keredson/chimes/README.md

Made front pages of [Hackaday](https://hackaday.com/2020/12/24/ringing-in-the-holidays-with-self-playing-chimes/) and [Hacker News](https://news.ycombinator.com/item?id=25482856)!

Musical Christmas Bells / Chimes
================================

This project is a battery powered musical chime set, loosely inspired by a set of microprocessor controlled
electro-mechanical real bells we had as kids, I think the
*Ye Merry Minstrel Caroling Christmas Bells*.  Other similar products had light-up bell decorations with a speaker,
like the *Caroling Christmas Bells* or *Mr Christmas Bells of Christmas* (but weren't real bells).

I wanted to recreate, but could not find a source of bells reasonably priced for this project.  So I substituted 
DIY chimes, which worked quite nicely IMO.

Built with a black walnut stand using copper tubing, 3d-printed hangers and controlled by an ESP32 running MicroPython.

Table of Contents
-----------------
- [Watch](#watch)
- [Overview](#overview)
- [Build](#build)
- [Software](#software)
- [Parts](#parts)
- [Tools](#tools-i-used)
- [Future Work](#future-work)

Watch 
-----

Some videos of it working:

Chimes playing 'Hark! The Herald Angels Sing'" (https://youtu.be/q78rXuhWD9I "Playing 'Hark! The Herald Angels Sing'")

- [Silent Night](https://youtu.be/6GucSdeh5fI)
- [Hark! The Herald Angels Sing](https://youtu.be/q78rXuhWD9I)
- [God Rest Ye Merry Gentlemen](https://youtu.be/Mc4dz5KQoJM)
- [Close up of the user interface](https://www.youtube.com/watch?v=E3LkCAIgiEA) (OLED display)

Overview
--------

I chose to implement these 12 notes (which cover a decent number of songs), but it can be extended as needed (up to the free GPIO pins):

- C5, D, E, F, F#, G, A, B, C6, D, E, F

I mapped C5 (and like) to C4 in software since an actual C4 chime didn't really sound like C4 due to secondary frequencies.  [This guide](http://leehite.org/Chimes.htm#Note%20Selection) was very useful to understand what's going on.

I've simplified a number of MIDI files to play, available [here](https://github.com/keredson/chimes/tree/main/songs).

Build
-----
This took me somewhere between 40-80 hours to design, code and build, starting with a "mandatory fun day" event at work.

Get some wood.  This is some black walnut I slabbed a year or two ago:



Make sure it's big enough to fit everything:



Cut and plane and do all the normal stuff to make it look pretty:





Cut 12 copper tubes to length.  I found an excellent guide at http://leehite.org/Chimes.htm.  I bought two 
[10' sections of type M 1/2" copper pipe](https://www.homedepot.com/p/Cerro-1-2-in-x-10-ft-Copper-Type-M-Hard-Temper-Straight-Pipe-1-2-M-10/100354198)
and cut them accorting to [this guide](https://github.com/keredson/chimes/blob/main/Family%20Copper%20Type%20M%20Red.pdf).




Drill and chamfer holes to hang them by at the hang points. 




Make the stand as you please.  I chose some pretty simple feet and through tenons.  






Make some electromagnets using 1.25" pieces of [3/8 in. Plain Steel Round Rod](https://www.homedepot.com/p/3-8-in-x-48-in-Plain-Steel-Round-Rod-801597/204273966).  3D print [end caps](https://github.com/keredson/chimes/blob/main/em_end.scad).




Use a helper if available!




Make some recesses in the underside of your wood for 12 hanger modules:



3D print [hangers](https://github.com/keredson/chimes/blob/main/striker_hanger.scad) and assemble:






Dead bug solder up each electromagnet.



Space is tight, I used more of the magnet wire for signaling.



Stainless screws for the capacitive buttons.  (Line them up better than I did!)



Use a nice power button:



Batteries...



Assemble:





OLED screen and [holder](https://github.com/keredson/chimes/blob/main/screen.scad):



Finish with Danish Oil.



Software
--------

The software uses regular MIDI files I whittled down in [LMMS](https://lmms.io/) to simple melodies.  I used a version of [Mido](https://github.com/mido/mido) I stripped down for memory reasons.  The ESP-32 runs [MicroPython](https://micropython.org/).

The main code is in [main.py](https://github.com/keredson/chimes/blob/main/main.py).  It's MVP (but not much more).

Parts
-----
- [3/8" steel rod](https://www.homedepot.com/p/3-8-in-x-48-in-Plain-Steel-Round-Rod-801597/204273966)
- [#8 Nuts](https://www.homedepot.com/p/Everbilt-8-32-Zinc-Plated-Machine-Screw-Nut-100-Pack-800252/204273373)
- [1/2 in. x 10 ft. Copper Type M Pipe](https://www.homedepot.com/p/Cerro-1-2-in-x-10-ft-Copper-Type-M-Hard-Temper-Straight-Pipe-1-2-M-10/100354198)
- [Springs](https://amzn.to/3h4naSZ)
- [Wood beads](https://amzn.to/3h4RPQa)
- [5V regulator](https://amzn.to/37yTkTy)
- [Battery charger circuit](https://amzn.to/38i1DCt)
- [Motor drivers](https://amzn.to/2KKibus)
- [18650 batteries](https://amzn.to/3hba7iQ) (Amazon doesn't seem to sell these directly, but they have these "flashlights" packages. =)
- [Barrel jack power connector](https://amzn.to/3mAEZdm)
- [Charger](https://amzn.to/3r7OgNP)
- [Battery holders](https://amzn.to/37zQsGc)
- [Wooden dowels](https://amzn.to/2Kooy79)
- [Magnet wire](https://amzn.to/34u02sd)
- [OLED display](https://amzn.to/3rbWZP1)
- [Power switch](https://amzn.to/34rKfKe)
- [ESP-32 microcontroller](https://amzn.to/3mCeJzv)
- [Thread](https://amzn.to/3h3diJ4)
- Wood!

Tools I Used
------------
Use what you have around, this is just what I used.

- [Chisel set](https://amzn.to/3r7Otk5)
- [Pipe cutter](https://www.homedepot.com/p/Husky-5-8-in-Junior-Tube-Cutter-80-511-111/304384093)
- [Metal ruler](https://www.homedepot.com/p/Empire-36-in-Aluminum-Straight-Edge-Ruler-403/100185157) (for accuracy)
- [Mortiser](https://amzn.to/3pbRD4e) (Total overkill / recent present to myself - a drill press or hand tools will work as well.)
- [Table saw](https://www.homedepot.com/p/RIDGID-13-Amp-10-in-Professional-Cast-Iron-Table-Saw-R4520/309412843)
- [Miter saw](https://www.homedepot.com/p/RIDGID-15-Amp-Corded-12-in-Dual-Bevel-Sliding-Miter-Saw-with-70-Deg-Miter-Capacity-and-LED-Cut-Line-Indicator-R4222/306939244)
- [Tenoning Jig](https://www.grizzly.com/products/grizzly-tenoning-jig/h7583)
- [Disc sander](https://www.harborfreight.com/12-inch-direct-drive-bench-top-disc-sander-43468.html)
- [3D printer](https://amzn.to/37xKRjq)
- [Planer](https://amzn.to/3h0KYr0)
- [Jointer](https://www.homedepot.com/p/RIDGID-6-Amp-Corded-6-1-8-in-Jointer-Planer-JP0610/202269174)
- [Center punch](https://amzn.to/2LRZKou)
- [Chamfer/Countersink Bit Set](https://amzn.to/3h1kUvV)
- [Sawmill](https://www.harborfreight.com/saw-mill-with-301cc-gas-engine-62366.html)

Future Work
-----------
The strikers return to their default position via gravity.  This is not reliable.  Sometimes they don't return at all due to friction, or they return part-way, resulting in the next strike being less effective.  I'm working on a redesign w/ springs and a wider swing arc.  This should make the chimes more consistent, and possibly allow harder strikes, variable intensity strikes, etc.

The ESP-32 has wifi.  I want to be able to control this over mobile.

Memory is very tight.  MicroPython supports baking in large libraries into the firmware to save memory.  (Their equivalent of `.pyc` files can be run directly from flash according to documentation.)  Figure out how to do this and create a custom firmware.

Be able to check and display battery voltage / % used.
