keredson/chimes/Family Copper Type M Red.pdf

# Precalculated Metal Chime Dimensions

# - Copper Type M, Red - Tubing sized in inches - Length and hang-point listed for inches & mm - Select chime size from the menu to the left of this page

Caution: if you are attempting to create exact notes for an orchestra setting, exact tuning is required and the use of an electronic tuning device or a good tuning ear is necessary. On the other hand, if you desire a good sounding set of chimes but do not need orchestra accuracy, then carefully cut the tube to the length suggested by this pre-

calculated table, or the DIY calculator listed on the website.

## Do not use these calculations for an orchestra or a musical setting unless you know for sure they tune to A4=440 Hz. An orchestra will typically tune for A4= 442, 43 or 44 Hz and this chart uses A4=440 Hz. Most symphony grade instruments are shipped with

A4=442 Hz.

Caution: While there are a host of apps for Chromatic Tuners available for an iPhone,

## iPad or Android, measuring the exact frequency and musical note of the chime is challenging at best. Non linearity of the human ear and the chime's non-harmonic

overtones are two reasons.

It is difficult to provide an exact recommendation when to use the a chromatic tuner to measure a chime's note, but in general, I find most any note below C4 difficult to measure and on occasion below C5. Long, low frequencies tubes, measure incorrectly because of the "missing fundamental effect”, and the preponderance of high amplitude overtones. Thick-walled tank chimes/bells can measure with surprising accuracy because its single pure tone above C4 is not cluttered with unimportant sidebands. More info about this topic is here: www.leehite.org/Chimes.htm#Tuning:

## From:

# www.leehite.org/Chimes.htm

OD inches = 0.625 0.569 | ID inches = | Material = Copper
Wall = 0.028 inches | * Tubing length calculated for fundamental frequency ** Hang Point is for fundamental frequency node
Octave Note | A=440 Freq. Hz | Length * inches | Hang Point** inches | Length * mm | Hang Point** mm | Octave Note | A=440 Freq. Hz | Length * inches | Hang Point** inches | Length * mm | Hang Point** mm
C1 | 32.70 | 56 1/2 | 12 11/16 | 1,434.0 | 321.5 | C5 | 523.30 | 14 1/8 | 3 3/16 | 358.5 | 80.4
# /Db C | 34.60 | 54 15/16 | 12 5/16 | 1,394.3 | 312.6 | # /Db C | 554.40 | 13 3/4 | 3 1/16 | 349.0 | 78.2

D | 36.70 | 53 5/16 | 11 15/16 | 1,353.1 | 303.4 | D | 587.30 | 13 5/16 | 3 | 337.9 | 75.8
# /Eb D | 38.90 | 51 13/16 | 11 5/8 | 1,315.0 | 294.8 | # /Eb D | 622.30 | 12 15/16 | 2 7/8 | 328.4 | 73.6

E | 41.21 | 50 5/16 | 11 1/4 | 1,276.9 | 286.3 | E | 659.30 | 12 9/16 | 2 13/16 | 318.8 | 71.5
F | 43.70 | 48 7/8 | 10 15/16 | 1,240.4 | 278.1 | F | 698.50 | 12 1/4 | 2 3/4 | 310.9 | 69.7
F#/Gb | 46.30 | 47 1/2 | 10 5/8 | 1,205.6 | 270.3 | F#/Gb | 740.00 | 11 7/8 | 2 11/16 | 301.4 | 67.6
G | 49.00 | 46 1/8 | 10 5/16 | 1,170.7 | 262.5 | G | 784.00 | 11 9/16 | 2 9/16 | 293.5 | 65.8
# /Ab G | 51.90 | 44 7/8 | 10 1/16 | 1,138.9 | 255.3 | # /Ab G | 830.60 | 11 3/16 | 2 1/2 | 283.9 | 63.7

A | 55.01 | 43 9/16 | 9 3/4 | 1,105.6 | 247.9 | A | 880.00 | 10 7/8 | 2 7/16 | 276.0 | 61.9
# /Bb A | 58.30 | 42 5/16 | 9 1/2 | 1,073.9 | 240.8 | # /Bb A | 932.30 | 10 9/16 | 2 3/8 | 268.1 | 60.1

B | 61.70 | 41 1/8 | 9 1/4 | 1,043.8 | 234.0 | B | 987.80 | 10 1/4 | 2 5/16 | 260.1 | 58.3
C2 | 65.40 | 39 15/16 | 8 15/16 | 1,013.6 | 227.3 | C6 | 1,046.50 | 10 | 2 1/4 | 253.8 | 56.9
# /Db C | 69.30 | 38 13/16 | 8 11/16 | 985.1 | 220.9 | # /Db C | 1,108.70 | 9 11/16 | 2 3/16 | 245.9 | 55.1

D | 73.41 | 37 11/16 | 8 7/16 | 956.5 | 214.4 | D | 1,174.61 | 9 7/16 | 2 1/8 | 239.5 | 53.7
# /Eb D | 77.80 | 36 5/8 | 8 3/16 | 929.5 | 208.4 | # /Eb D | 1,244.50 | 9 3/16 | 2 1/16 | 233.2 | 52.3

E | 82.40 | 35 9/16 | 8 | 902.6 | 202.4 | E | 1,318.50 | 8 7/8 | 2 | 225.2 | 50.5
F | 87.30 | 34 9/16 | 7 3/4 | 877.2 | 196.7 | F | 1,397.00 | 8 5/8 | 1 15/16 | 218.9 | 49.1
F#/Gb | 92.50 | 33 9/16 | 7 1/2 | 851.8 | 191.0 | F#/Gb | 1,480.00 | 8 3/8 | 1 7/8 | 212.6 | 47.7
G | 98.01 | 32 5/8 | 7 5/16 | 828.0 | 185.6 | G | 1,568.00 | 8 3/16 | 1 13/16 | 207.8 | 46.6
# /Ab G | 103.80 | 31 11/16 | 7 1/8 | 804.2 | 180.3 | # /Ab G | 1,661.20 | 7 15/16 | 1 3/4 | 201.5 | 45.2

A | 110.00 | 30 13/16 | 6 15/16 | 782.0 | 175.3 | A | 1,760.00 | 7 11/16 | 1 3/4 | 195.1 | 43.7
# /Bb A | 116.50 | 29 15/16 | 6 11/16 | 759.8 | 170.4 | # /Bb A | 1,864.60 | 7 1/2 | 1 11/16 | 190.4 | 42.7

B | 123.50 | 29 1/16 | 6 1/2 | 737.6 | 165.4 | B | 1,975.50 | 7 1/4 | 1 5/8 | 184.0 | 41.3
C3 | 130.81 | 28 1/4 | 6 5/16 | 717.0 | 160.7 | C7 | 2,093.00 | 7 1/16 | 1 9/16 | 179.2 | 40.2
# /Db C | 138.60 | 27 7/16 | 6 1/8 | 696.4 | 156.1 | # /Db C | 2,217.40 | 6 7/8 | 1 9/16 | 174.5 | 39.1

D | 146.80 | 26 11/16 | 6 | 677.3 | 151.9 | D | 2,349.20 | 6 11/16 | 1 1/2 | 169.7 | 38.1
# /Eb D | 155.60 | 25 7/8 | 5 13/16 | 656.7 | 147.2 | # /Eb D | 2,489.01 | 6 1/2 | 1 7/16 | 165.0 | 37.0

E | 164.80 | 25 3/16 | 5 5/8 | 639.3 | 143.3 | E | 2,637.00 | 6 5/16 | 1 7/16 | 160.2 | 35.9
F | 174.61 | 24 7/16 | 5 1/2 | 620.2 | 139.1 | F | 2,794.00 | 6 1/8 | 1 3/8 | 155.5 | 34.9
F#/Gb | 185.00 | 23 3/4 | 5 5/16 | 602.8 | 135.1 | F#/Gb | 2,960.00 | 5 15/16 | 1 5/16 | 150.7 | 33.8
G | 196.00 | 23 1/16 | 5 3/16 | 585.3 | 131.2 | G | 3,136.00 | 5 3/4 | 1 5/16 | 145.9 | 32.7
# /Ab G | 207.70 | 22 7/16 | 5 | 569.5 | 127.7 | # /Ab G | 3,322.41 | 5 5/8 | 1 1/4 | 142.8 | 32.0

A | 220.00 | 21 13/16 | 4 7/8 | 553.6 | 124.1 | A | 3,520.00 | 5 7/16 | 1 1/4 | 138.0 | 30.9
# /Bb A | 233.10 | 21 3/16 | 4 3/4 | 537.7 | 120.6 | # /Bb A | 3,729.20 | 5 5/16 | 1 3/16 | 134.8 | 30.2

B | 246.90 | 20 9/16 | 4 5/8 | 521.9 | 117.0 | B | 3,951.00 | 5 1/8 | 1 1/8 | 130.1 | 29.2
C4 | 261.60 | 20 | 4 1/2 | 507.6 | 113.8 | C8 | 4,186.00 | 5 | 1 1/8 | 126.9 | 28.5
# /Db C | 277.20 | 19 3/8 | 4 3/8 | 491.7 | 110.2 | # /Db C | 4,434.81 | 4 7/8 | 1 1/16 | 123.7 | 27.7

D | 293.70 | 18 7/8 | 4 1/4 | 479.0 | 107.4 | D | 4,698.40 | 4 11/16 | 1 1/16 | 119.0 | 26.7
# /Eb D | 311.10 | 18 5/16 | 4 1/8 | 464.8 | 104.2 | # /Eb D | 4,978.00 | 4 9/16 | 1 | 115.8 | 26.0

E | 329.61 | 17 13/16 | 4 | 452.1 | 101.4 | E | 5,274.00 | 4 7/16 | 1 | 112.6 | 25.3
F | 349.30 | 17 5/16 | 3 7/8 | 439.4 | 98.5 | F | 5,588.00 | 4 5/16 | 15/16 | 109.5 | 24.5
F#/Gb | 370.00 | 16 13/16 | 3 3/4 | 426.7 | 95.7 | F#/Gb | 5,920.00 | 4 3/16 | 15/16 | 106.3 | 23.8
G | 392.00 | 16 5/16 | 3 11/16 | 414.0 | 92.8 | G | 6,272.00 | 4 1/16 | 15/16 | 103.1 | 23.1
# /Ab G | 415.30 | 15 7/8 | 3 9/16 | 402.9 | 90.3 | # /Ab G | 6,644.80 | 3 15/16 | 7/8 | 99.9 | 22.4

A | 440.01 | 15 3/8 | 3 7/16 | 390.2 | 87.5 | A | 7,040.00 | 3 7/8 | 7/8 | 98.3 | 22.0
# /Bb A | 466.20 | 14 15/16 | 3 3/8 | 379.1 | 85.0 | # /Bb A | 7,458.40 | 3 3/4 | 13/16 | 95.2 | 21.3

B | 493.91 | 14 9/16 | 3 1/4 | 369.6 | 82.9 | B | 7,902.01 | 3 5/8 | 13/16 | 92.0 | 20.6
| | | | | | C9 | 8,367.01 | 3 9/16 | 13/16 | 90.4 | 20.3

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

B | 493.91 | 32 7/8 | 7 3/8 | 834.4 | 187.1 | B | 7,902.01 | 8 3/16 | 1 13/16 | 207.8 | 46.6
| | | | | | C9 | 8,367.01 | 8 | 1 13/16 | 203.0 | 45.5

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

### www.home.fuse.net/engineering/Chimes.htm

Copper, Type M (Red) | Nominal size = 3.0" | A=440 Hz, tube open at both ends
