keredson/chimes/3d_files/em_end.scad

difference() {
    cylinder(2,19/2,19/2, $fn=50);
    cylinder(2,9.8/2,9.8/2, $fn=50);
}
