keredson/chimes/(list of files, cad)

Other CAD files:
3d_files/striker_holder.scad
