keredson/chimes/(commit log)

2020-12-22 trigger buttons on a moving average instead of fixed threshold
    [main.py]
2020-12-23 moved scad files into their own dir
    [em_end.scad, screen.scad, striker_hanger.scad, striker_hinge.scad, striker_holder.scad]
